mcquerol/parking-aid-veroboard/FinalVeroboard.PNG

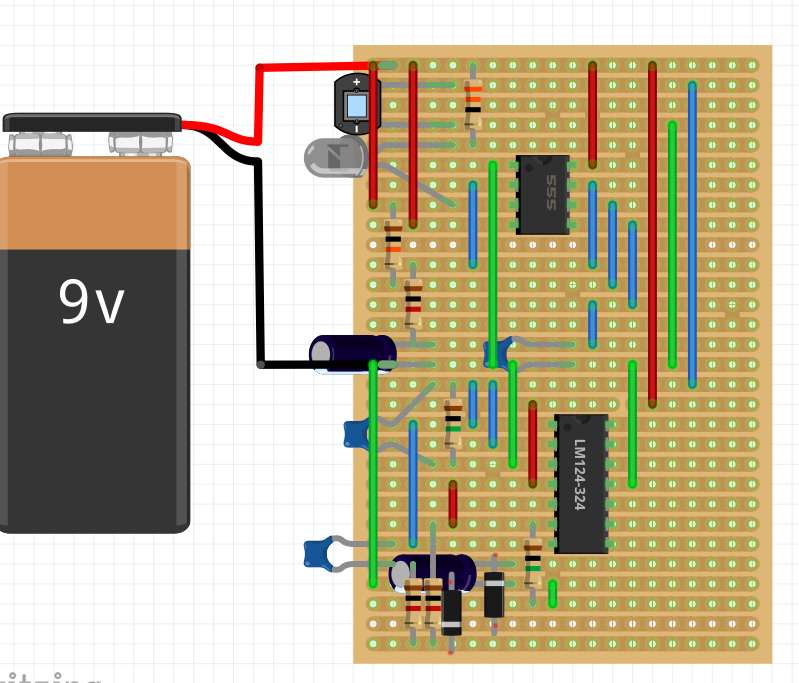
FinalVeroboard.PNG
