mcquerol/parking-aid-veroboard/Technology project photos/IMG-20180314-WA0000.jpeg

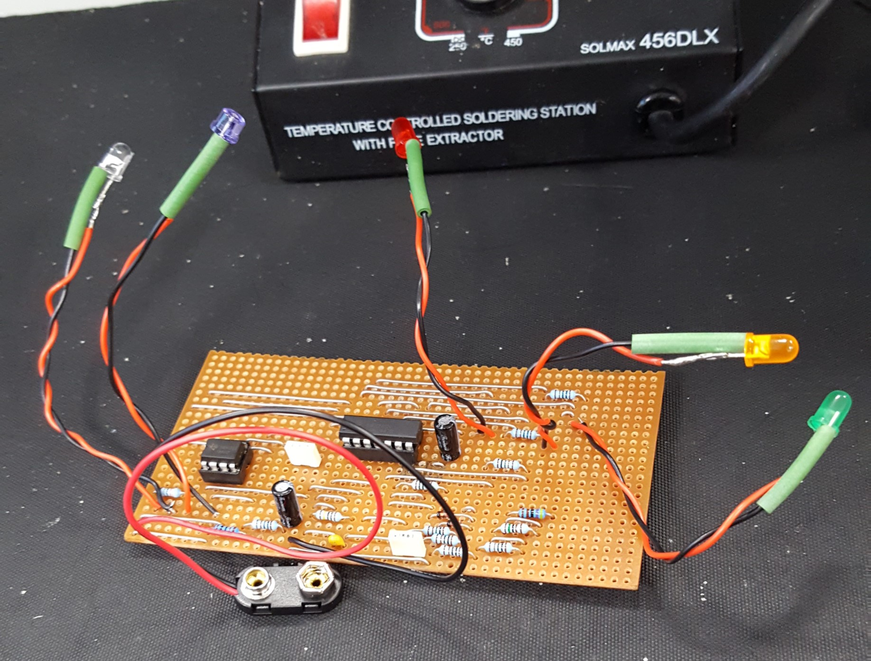
Technology project photos/IMG-20180314-WA0000.jpeg
