mcquerol/parking-aid-veroboard/Technology project photos/555 timer half of the parking aid.PNG

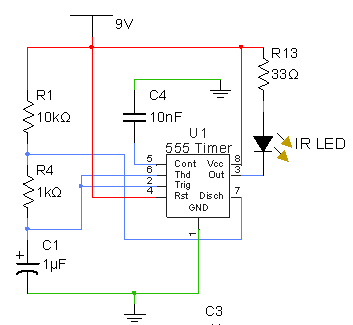
Technology project photos/555 timer half of the parking aid.PNG
