mcquerol/parking-aid-veroboard/Technology project photos/555 timer.PNG

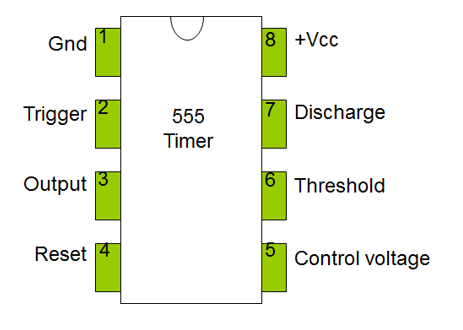
Technology project photos/555 timer.PNG
