mcquerol/parking-aid-veroboard/Technology project photos/comparator logic.PNG

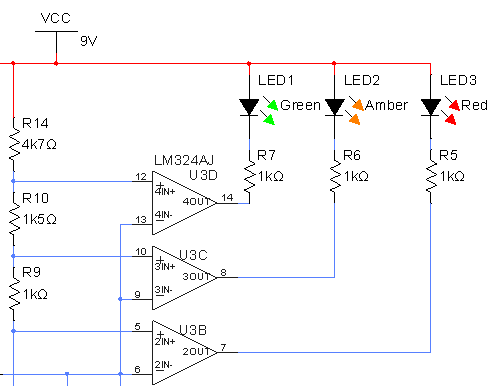
Technology project photos/comparator logic.PNG
