mcquerol/parking-aid-veroboard/Technology project photos/photodiode.PNG

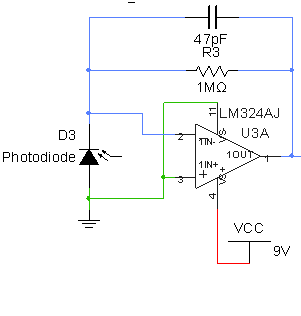
Technology project photos/photodiode.PNG
