mcquerol/parking-aid-veroboard/timetablefortp.jpg

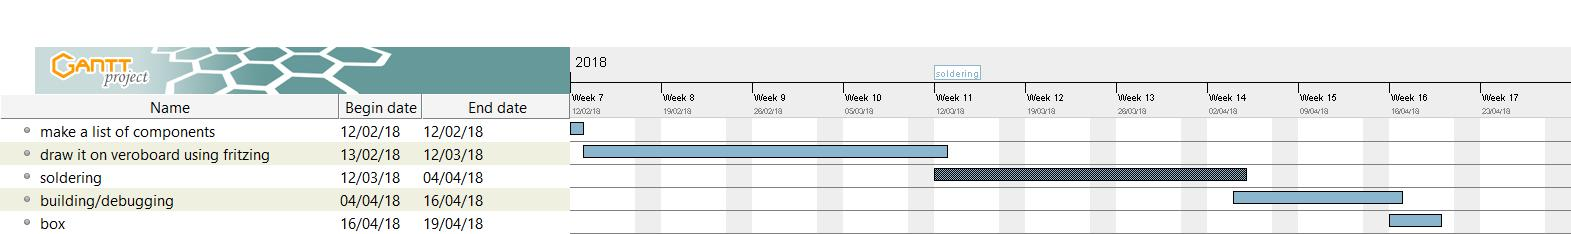
timetablefortp.jpg
