mcquerol/parking-aid-veroboard/components list.xlsx

Name | Value/Markings | Description
U1 | NE555P | 555 timer
R1 | 10kΩ | Resistor
R4 | 1kΩ | Resistor
C1 | 1μF | Capacitor (Polarized)
C4 | 10nF | Capacitor (Ceramic)
R13 | 33Ω | Resistor
IR LED |  | IR LED
D3 |  | Photodiode
C3 | 47pf | Capacitor (Ceramic)
R3 | 1MΩ | Resistor
U3A | LM324AJ | Op-Amp Comparator
C2 | 0.1μF | Capacitor (Ceramic)
R12 | 1kΩ | Resistor
D1 | 1N4148 | Diode
D2 | 1N4148 | Diode
R11 | 1Ω | Resistor
R14 | 4.7kΩ | Resistor
R10 | 1.5kΩ | Resistor
R9 | 1kΩ | Resistor
R8 | 1kΩ | Resistor
C5 | 1μF | Capacitor (Polarized)
R2 | 1MΩ | Resistor
U3D | LM324AJ | Op-Amp Comparator
U3C | LM324AJ | Op-Amp Comparator
U3B | LM324AJ | Op-Amp Comparator
R7 | 1kΩ | Resistor
R6 | 1kΩ | Resistor
R5 | 1kΩ | Resistor
LED 1 |  | LED (Green)
LED 2 |  | LED (Amber)
LED 3 |  | LED (Red)
Datasheets
555 timer (U1) | https://people.eecs.berkeley.edu/~tkg/ EE100_42_F09/Documents/Laboratory/Lab5/LAB5.pdf
IR lED | https://cdn-shop.adafruit.com/ datasheets/IR333_A_datasheet.pdf (https://cdn-shop.adafruit.com/datasheets/IR333_A_datasheet.pdf)
Photodiode (D3) | https://www.vishay.com/ docs/81521/bpw34.pdf (https://www.vishay.com/docs/81521/bpw34.pdf)
Op-Amp Comparator (U3A, U3B, U3C, U3D) | http://doc.chipfind.ru/nsc/ lm324aj.htm (http://doc.chipfind.ru/nsc/lm324aj.htm)
Diode (D1 & D2) | https://www.vishay.com/docs/81857/1n4148.pdf
