mcquerol/parking-aid-veroboard/(list of files, drawings)

Other design files:
BetterParkingAidTransmitter.fzz
ParkingAid_Reciever.fzz
ParkingAid_transhmitter.fzz
