mcquerol/parking-aid-veroboard/(commit log)

2023-08-04 Adding BetterParkingAidTransmitter.fzz on 2018-03-10
    [BetterParkingAidTransmitter.fzz]
2023-08-04 Adding components list.xlsx on 2018-04-28
    [components list.xlsx]
2023-08-04 Adding ParkingAid_Reciever.fzz on 2018-02-26
    [ParkingAid_Reciever.fzz]
2023-08-04 Adding ParkingAid_transhmitter.fzz on 2018-02-26
    [ParkingAid_transhmitter.fzz]
2023-08-04 Adding Technology project photos\555 timer half of the parking aid.PNG on 2018-03-27
2023-08-04 Adding Technology project photos\555 timer.PNG on 2018-03-27
